loggerhead-instruments/OpenTag3/Manual/OpenTag3Top.JPG

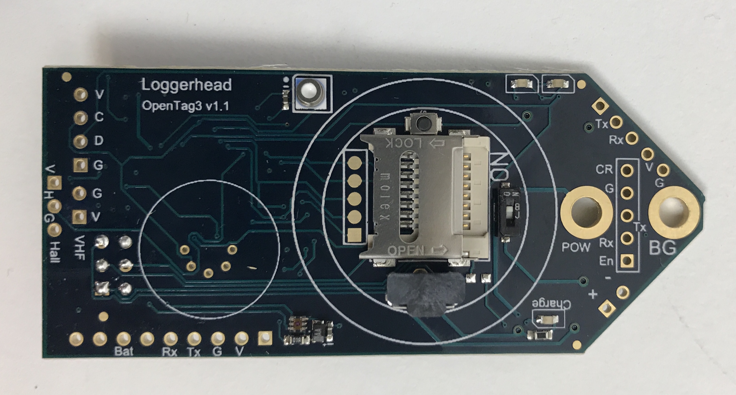
Manual/OpenTag3Top.JPG
