loggerhead-instruments/OpenTag3/Manual/OpenTag3Bottom.JPG

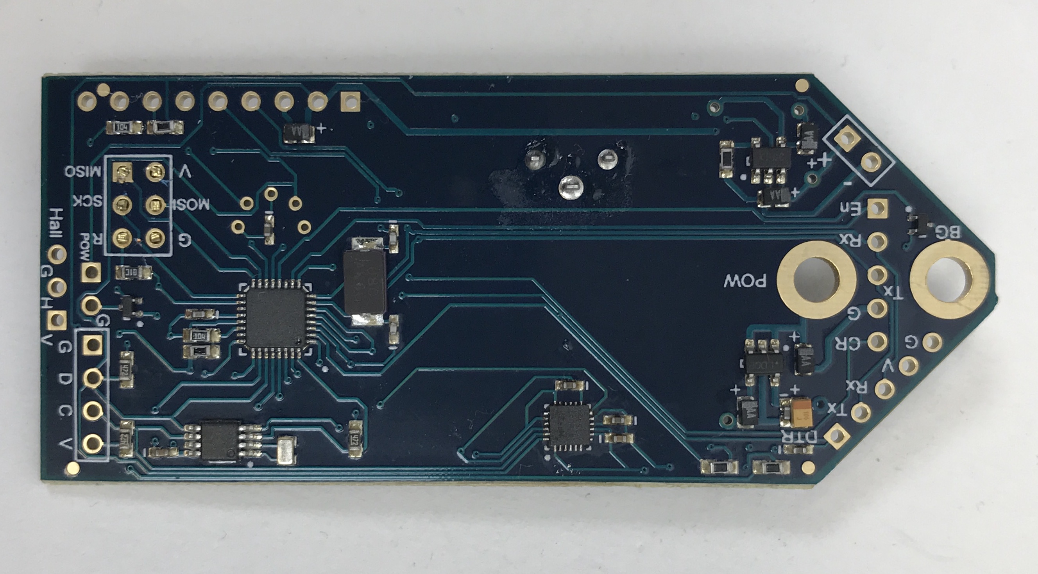
Manual/OpenTag3Bottom.JPG
