loggerhead-instruments/OpenTag3/README.md

# OpenTag3
Open source motion datalogger
