loggerhead-instruments/OpenTag3/Altium/OpenTag3.step

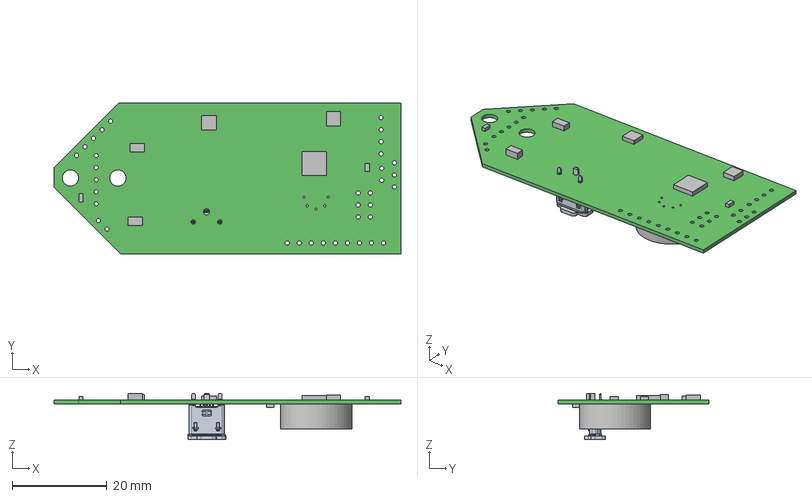
[picture p3: CAD file, 2017-10-24]
Altium/OpenTag3.step
73.2 x 31.8 x 9.80 mm
Board
Extruded x 8
