loggerhead-instruments/OpenTag3/(list of files, cad)

Other CAD files:
Altium/OpenTag3.DWG
