loggerhead-instruments/OpenTag3/Manual/OpenTag3.pptx

Pressure
Temperature

Stop

Status LEDs

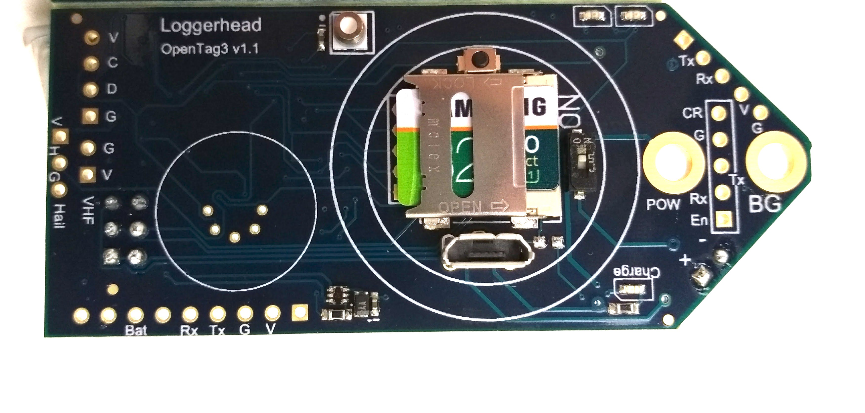
[picture p4: figure]

On/Off

Z (down)

X

Y

Burn Ground

+ Battery

Red when charging

Light
Sensor

microSD

microUSB charger
