loggerhead-instruments/OpenTag3/Manual/IMU_orientation.png

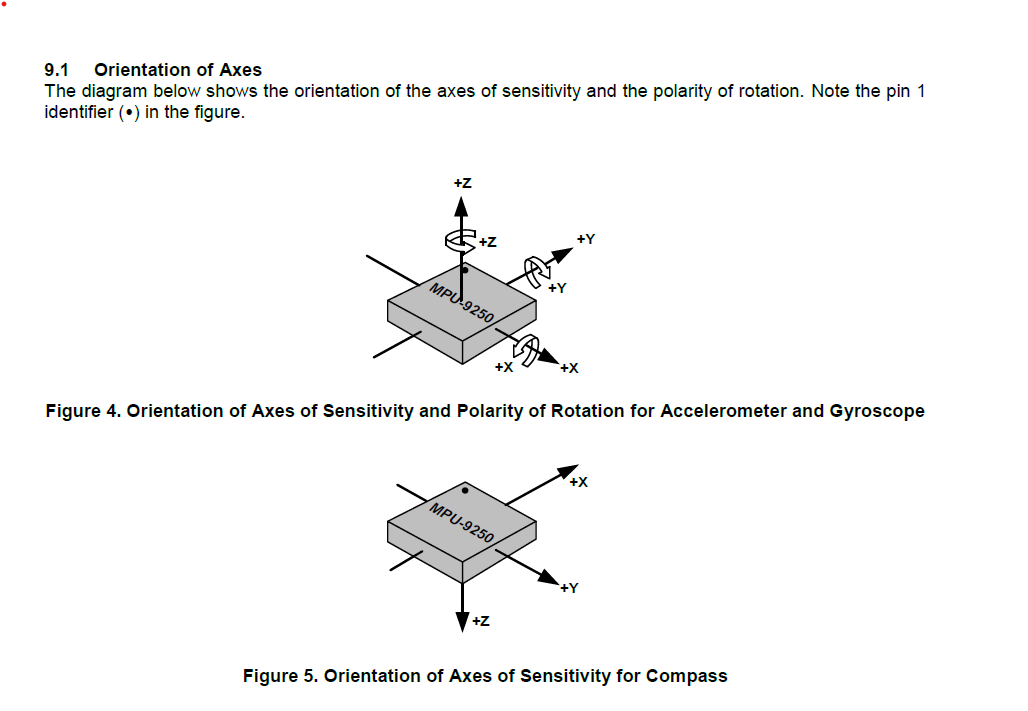
Manual/IMU_orientation.png
