loggerhead-instruments/OpenTag3/Manual/OpenTag3.png

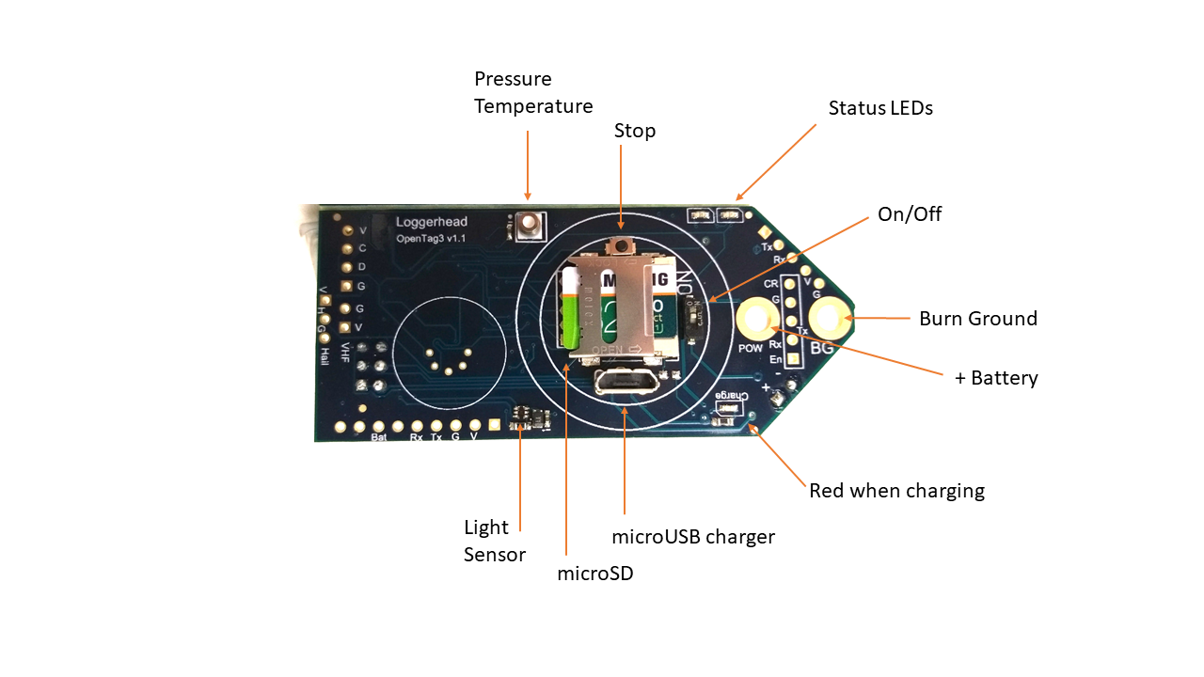
Manual/OpenTag3.png
