loggerhead-instruments/OpenTag3/MATLAB/OpenTag_NED_example_Data/NED_test.csv

accelX | accelY | accelZ | magX | magY | magZ | gyroX | gyroY | gyroZ
26 | 15 | -2141 | -117 | 355 | -39 | 38 | 18 | 2
49 | 3 | -2082 | -121 | 353 | -35 | 41 | -43 | 36
51 | -28 | -2085 | -119 | 365 | -47 | 5 | -38 | 17
42 | -13 | -2099 | -110 | 352 | -42 | -14 | -80 | -27
45 | 5 | -2102 | -120 | 358 | -44 | -20 | -39 | -20
59 | 28 | -2088 | -116 | 358 | -42 | -27 | 39 | 59
58 | 9 | -2085 | -113 | 359 | -39 | -37 | 40 | 108
38 | 23 | -2109 | -123 | 351 | -47 | -3 | 1 | 40
44 | 16 | -2105 | -114 | 354 | -42 | 49 | 25 | -62
57 | 22 | -2091 | -122 | 350 | -46 | 60 | 9 | -50
63 | 38 | -2092 | -118 | 350 | -48 | 49 | -9 | 22
54 | 17 | -2075 | -122 | 360 | -46 | 34 | -79 | 84
55 | -11 | -2085 | -111 | 357 | -45 | 4 | -10 | 89
35 | 22 | -2128 | -116 | 350 | -44 | -54 | 50 | 162
53 | 6 | -2107 | -115 | 353 | -39 | -16 | -65 | 134
58 | 3 | -2074 | -120 | 354 | -46 | -12 | -117 | 64
47 | 34 | -2099 | -112 | 352 | -46 | -46 | -74 | 73
29 | 41 | -2122 | -116 | 362 | -44 | -17 | 18 | 90
28 | 9 | -2111 | -114 | 360 | -48 | 3 | 44 | 130
45 | 23 | -2103 | -115 | 359 | -45 | -29 | -11 | 173
69 | 31 | -2062 | -123 | 355 | -39 | 25 | -4 | 77
32 | -30 | -2098 | -120 | 354 | -50 | 23 | -14 | 94
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
