loggerhead-instruments/OpenTag3/Manual/accelerometer_tag_assy-110619-1.pdf

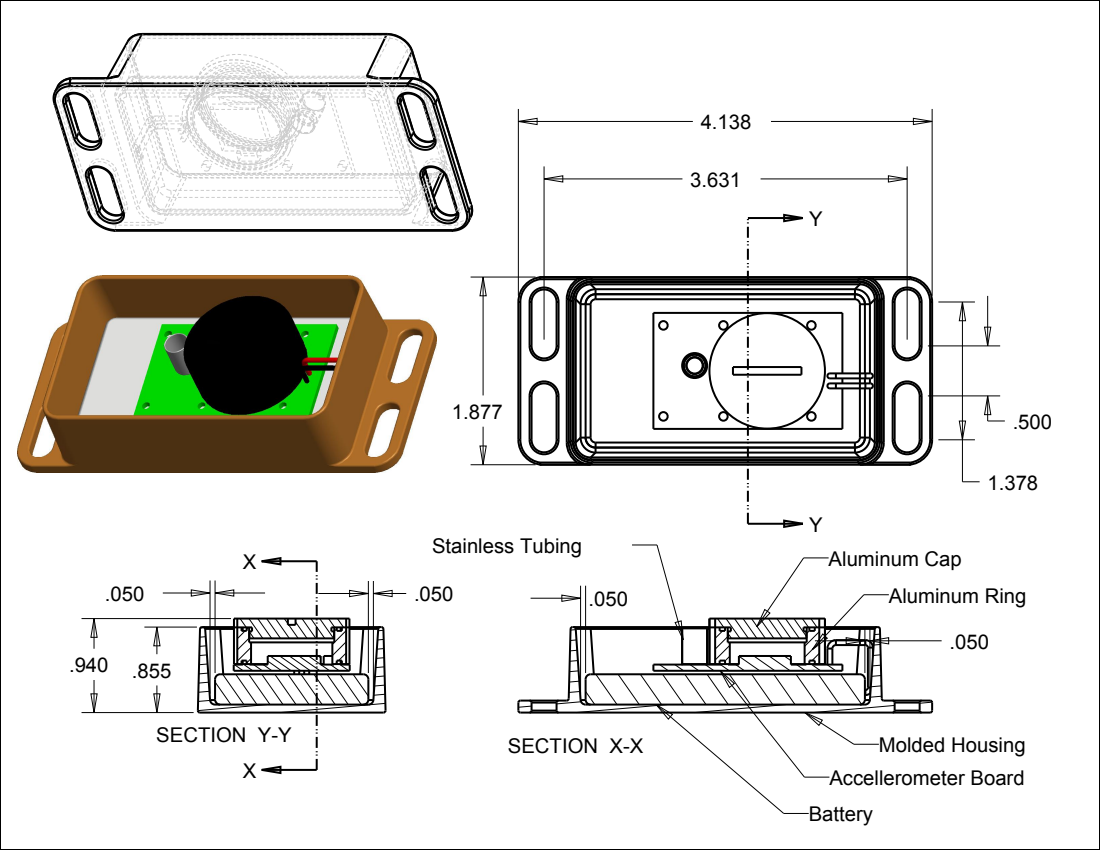
[picture p15: page 1]
SECTION Y-Y; Molded Housing; Aluminum Cap Aluminum Ring; Accellerometer Board Battery; SECTION X-X; Stainless Tubing
