loggerhead-instruments/OpenTag3/(list of files, drawings)

Other design files:
Altium/HallSensor/HallSensor.PcbDoc
Altium/HallSensor/HallSensor.PrjPCB
Altium/HallSensor/HallSensor.SchDoc
Altium/OpenTag3.PcbDoc
Altium/OpenTag3.PrjPCB
Altium/OpenTag3.SchDoc
Altium/OpenTag3_Sensors.SchDoc
