loggerhead-instruments/OpenTag3/Arduino/OpenTag3/OpenTag3.ino

// Copyright Loggerhead Instruments, 2017-2019
// David Mann

// OpenTag3 is an underwater motion datalogger
// designed around the ATMEGA328p

// OpenTag3 supports the following sensors:
// Pressure/Temperature
// acclerometer/magnetometer
// RGB light

// 2019-08-23: If no pressure sensor detected, don't sample it.
// 2019-03-05: Sleep uC and power down IMU during sleep interval.
//             showFail() returns after 10 seconds of blinking
// Run power: ~12 mA
// Sleep power: ~0.8 mA

//#include <Wire.h>
#include <SPI.h>
#include <SdFat.h>
#include <MsTimer2.h> 
#include <avr/sleep.h>
#include <avr/power.h>
#include <avr/wdt.h>
#include <prescaler.h>

#define SDA_PORT PORTC
#define SDA_PIN 4
#define SCL_PORT PORTC
#define SCL_PIN 5

#define I2C_TIMEOUT 100
#define I2C_FASTMODE 1

#include <SoftWire.h>
#include <avr/io.h>
#include <avr/boot.h>

SoftWire Wire = SoftWire();

//
// DEV SETTINGS
//
char codeVer[12] = "2020-04-27";
int printDiags = 1;

int recDur = 3600; // 3600 seconds per hour
int recInt = 0;
int LED_EN = 1; //enable green LEDs flash 1x per pressure read. Can be disabled from script.

boolean HALL_EN = 0; 
boolean HALL_LED_EN = 0; //flash red LED for Hall sensor
boolean ADC0_EN = 0;

#define pressAddress 0x76
float MS58xx_constant = 8192.0; // for 30 bar sensor
// float MS58xx_constant = 327680.0; // for 2 bar sensor; will switch to this if 30 bar fails to give good depth

// pin assignments
#define chipSelect  10
#define LED_GRN A3  // PD4
#define LED_RED 4 // PC3
#define BURN 8     // PB0
#define VHFPOW 9   // PB1
#define BUTTON1 A2 // PC2
#define BAT_VOLTAGE A7// ADC7
#define HALL 3 // PD3 (INT1)
#define CAM_TRIG 5 
#define CAM_EN 6  // High enables 5V power boost board

// SD file system
SdFat sd;
File dataFile;
int fileCount; 

int ssCounter; // used to get different sample rates from one timer based on imu_srate
byte clockprescaler=0;  //clock prescaler

//
// SENSORS
//
byte imuTempBuffer[20];
int imuSrate = 100; // must be integer for timer
int sensorSrate = 1; // must divide into imuSrate
int slowRateMultiple = imuSrate / sensorSrate;
int speriod = 1000 / imuSrate;

//Pressure and temp calibration coefficients
uint16_t PSENS; //pressure sensitivity
uint16_t POFF;  //Pressure offset
uint16_t TCSENS; //Temp coefficient of pressure sensitivity
uint16_t TCOFF; //Temp coefficient of pressure offset
uint16_t TREF;  //Ref temperature
uint16_t TEMPSENS; //Temperature sensitivity coefficient
byte Tbuff[3];
byte Pbuff[3];
volatile float depth, temperature, pressure_mbar;
boolean togglePress = 0; // flag to toggle conversion of temperature and pressure

// RGB
int16_t islRed;
int16_t islBlue;
int16_t islGreen;
int16_t accelX, accelY, accelZ;
int16_t magX, magY, magZ;
int16_t gyroX, gyroY, gyroZ;

int accel_scale = 16;

// impeller spin counter
volatile int spin;
volatile float adc0Val;

// System Modes and Status
int mode = 0; //standby = 0; running = 1
volatile float voltage;

// Time
volatile byte second = 0;
volatile byte minute = 0;
volatile byte hour = 17;
volatile byte day = 1;
volatile byte month = 1;
volatile byte year = 17;

unsigned long t, startTime, endTime, burnTime, startUnixTime;
int burnFlag = 0;
long burnSeconds;

void setup() {
  Serial.begin(115200);
  pinMode(LED_GRN, OUTPUT);
  pinMode(LED_RED, OUTPUT);
  pinMode(BURN, OUTPUT);
  pinMode(VHFPOW, OUTPUT);
  pinMode(BUTTON1, INPUT_PULLUP);
  pinMode(HALL, INPUT);
  pinMode(CAM_TRIG, OUTPUT);
  pinMode(CAM_EN, OUTPUT);
  if(ADC0_EN) pinMode(A0, INPUT);
  pinMode(BAT_VOLTAGE, INPUT);
  
  digitalWrite(BURN,LOW);
  digitalWrite(LED_RED,LOW);
  digitalWrite(LED_GRN,HIGH);
  digitalWrite(VHFPOW, LOW);
  digitalWrite(BURN, LOW);
  digitalWrite(CAM_TRIG, HIGH);
  digitalWrite(CAM_EN, HIGH);
  pinMode(2, INPUT); //Arduino Interrupt2
  pinMode(3, INPUT); //Arduino Interrupt1

  Serial.println("OT3");
  Wire.begin();
  
  Serial.println("microSD");
  // see if the card is present and can be initialized:
  sd.begin(chipSelect, SPI_FULL_SPEED);
//  while (!sd.begin(chipSelect, SPI_FULL_SPEED)) {
//    Serial.println("fail");
//    digitalWrite(LED_GRN, LOW);
//    digitalWrite(LED_RED, HIGH);
//    delay(200);
//    digitalWrite(LED_RED, LOW);
//    delay(100);
//  }
  loadScript(); // do this early to set time
  
  // recalculate sample rates in case changed from script
  slowRateMultiple = imuSrate / sensorSrate;
  speriod = 1000 / imuSrate;
  
  initSensors();
  readRTC();
  Serial.print(year); Serial.print("-");
  Serial.print(month);Serial.print("-");
  Serial.print(day);Serial.print(" ");
  Serial.print(hour);Serial.print(":");
  Serial.print(minute);Serial.print(":");
  Serial.println(second);

  startUnixTime = t;

 logFileWrite();
  
  if(burnFlag==2){
    burnTime = t + burnSeconds;
    Serial.print("Burn set");
    Serial.println(burnTime);
  }

  if(startTime==0) startTime = t + 10; // give some time for camera to power on
  Serial.print("Time:"); Serial.println(t);
  Serial.print("Start Time:"); Serial.println(startTime);
  digitalWrite(LED_GRN, LOW);
  digitalWrite(LED_RED, LOW);

  setClockPrescaler(clockprescaler); // set clockprescaler from script file
  wdtInit();
  //setupWDT(11); // initialize and activate WDT with maximum period (~500 ms)
}

void loop() {
  while(mode==0){
    // resetWdt();
    readRTC();
    checkBurn();
    checkVHF();
    Serial.print(t); Serial.print(" "); Serial.println(startTime);

    if(LED_EN){
      digitalWrite(LED_GRN, HIGH);
      digitalWrite(LED_RED, HIGH);
      delay(3);
    }
    digitalWrite(LED_GRN, LOW);
    digitalWrite(LED_RED, LOW);
    enterSleep();

    if(t >= startTime){
      endTime = startTime + recDur;
      startTime += recDur + recInt;  // this will be next start time for interval record
      mpuInit(1);
      fileInit();
      updateTemp();  // get first reading ready
      mode = 1;
      camStart();
      startInterruptTimer(speriod, clockprescaler);
      attachInterrupt(digitalPinToInterrupt(HALL), spinCount, RISING);
    }
  } // mode = 0


  while(mode==1){
    // resetWdt();
    
    // check if time to close
    if(t>=endTime){
      stopTimer();
      dataFile.close(); // close file
      if(t - startUnixTime > 3600) LED_EN = 0; // disable green LED flashing after 3600 s
      
      if(recInt==0){  // no interval between files
        endTime += recDur;  // update end time
        fileInit();
        startInterruptTimer(speriod, clockprescaler);
      }
      else{
        mode = 0;
        mpuInit(0); // MPU to sleep
      //  wdtInit(); // start wdt
      }
    }

    // Check if stop button pressed
    if(digitalRead(BUTTON1)==0){
      delay(10); // simple deBounce
      if(digitalRead(BUTTON1)==0){
        camStop();
        stopTimer();
        digitalWrite(LED_RED, HIGH);
        dataFile.close();
        delay(30000);
        // wait 30 s to stop
        startInterruptTimer(speriod, clockprescaler);
        fileInit();
        digitalWrite(LED_RED, LOW);
      }
    }

//    // Check if voltage is low
//    if(voltage < 3.3){
//      readVoltage(); // check again to be sure
//      if(voltage < 3.3){
//        camStop();
//        stopTimer();
//        dataFile.close();
//        // go into low power mode
//        mpuInit(0); // sleep IMU
//        islSleep(); // sleep light sensor
//        setClockPrescaler(3); // run at 1 MHz
//        delay(1000);
//        camPowOff();
//        digitalWrite(VHFPOW, HIGH); // turn on VHF
//        digitalWrite(BURN, HIGH);   // burn
//        while(1){
//          digitalWrite(LED_RED, HIGH);
//          delay(10);
//          digitalWrite(LED_RED, LOW);
//          delay(2000);
//        }
//      }
//    }
  } // mode = 1
}


boolean ledState;
void spinCount(){
  ledState = !ledState;
  if(HALL_LED_EN) digitalWrite(LED_RED, ledState);
  spin++;
}

void initSensors(){

  digitalWrite(VHFPOW, HIGH);
  digitalWrite(BURN, HIGH);

  
  
// Battery Voltage
      readVoltage();
      Serial.print(voltage);
      Serial.println(" V");

  if(voltage < 3.5){
    showFail(50); //battery voltage read fail
  }
  
  reset_alarm();

  readRTC();
  int oldSecond = second;

  // flash LED with current hour
  readRTC();
  Serial.print(year); Serial.print("-");
  Serial.print(month); Serial.print("-");
  Serial.print(day); Serial.print(" ");
  Serial.print(hour); Serial.print(":");
  Serial.print(minute); Serial.print(":");
  Serial.println(second);

  digitalWrite(LED_RED, HIGH);
  delay(1000);
  for(int i=0; i<hour; i++){
    delay(300);
    digitalWrite(LED_GRN, HIGH);
    delay(80);
    digitalWrite(LED_GRN, LOW);
  }
  delay(400);
  digitalWrite(LED_RED, LOW);
  readRTC();
  Serial.print(hour); Serial.print(":");
  Serial.print(minute); Serial.print(":");
  Serial.println(second);
  if(second==oldSecond){
    showFail(100); // clock not ticking
    Serial.println("Clock fail");
  }

  // Pressure/Temperature
  if (pressInit()==0){
    Serial.println("Pressure fail");
    showFail(200); // pressure sensor fail
  }
  Serial.println("P D T");
  for(int x=0; x<5; x++){
    updatePress();
    delay(100);
    readPress();
    updateTemp();
    delay(100);
    readTemp();
    calcPressTemp();
    Serial.print(pressure_mbar); Serial.print(" ");
    Serial.print(depth); Serial.print(" ");
    Serial.println(temperature);
  }

  if(depth<-1.0 | depth>1.0){
    // out of range, try settings for 2 bar sensor
    MS58xx_constant = 327680.0;
    calcPressTemp();
    Serial.print(pressure_mbar); Serial.print(" ");
    Serial.print(depth); Serial.print(" ");
    Serial.println(temperature);
  }

  if (islInit()==0) {
    Serial.println("RGB fail");
    showFail(200);
  }
  
  Serial.println("RGB");
  for (int x=0; x<8; x++){
    islRead();
    Serial.print(islRed); Serial.print("\t");
    Serial.print(islGreen); Serial.print("\t");
    Serial.println(islBlue);
    delay(100);
  }

  Serial.print("MPU");
  int eCode = mpuInit(1);
  if(eCode!=0) {
    Serial.print("MPU fail ");
    Serial.println(eCode);
    showFail(300);
  }
  for(int i=0; i<10; i++){
      readImu();
      calcImu();
      printImu();
      delay(100);
  }

  // sensor out of spec warning
  if(depth<-1.0 | depth>1.0 | islRed==0 | accelX==-1 | magX==-1 | gyroX==-1) {
    for(int i=0; i<300; i++){ //flash fast for  seconds
      digitalWrite(LED_RED, HIGH);
      delay(20);
      digitalWrite(LED_RED, LOW);
      delay(30);
    }
  }
  
  digitalWrite(VHFPOW, LOW);
  digitalWrite(BURN, LOW);
}

void showFail(int blinkInterval){
  digitalWrite(LED_GRN, LOW);
  int count = 5000 / blinkInterval;
  if(count < 100) count = 100;
  for(int n=0; n<count; n++){
    digitalWrite(LED_RED, HIGH);
    delay(blinkInterval);
    digitalWrite(LED_RED, LOW);
    delay(blinkInterval);
  }
}

void calcImu(){
  accelX = (int16_t) ((int16_t)imuTempBuffer[0] << 8 | imuTempBuffer[1]);    
  accelY = (int16_t) ((int16_t)imuTempBuffer[2] << 8 | imuTempBuffer[3]);   
  accelZ = (int16_t) ((int16_t)imuTempBuffer[4] << 8 | imuTempBuffer[5]);    
  
 // gyroTemp = (int16_t) (((int16_t)imuTempBuffer[6]) << 8 | imuTempBuffer[7]);   
 
  gyroX = (int16_t)  (((int16_t)imuTempBuffer[8] << 8) | imuTempBuffer[9]);   
  gyroY = (int16_t)  (((int16_t)imuTempBuffer[10] << 8) | imuTempBuffer[11]); 
  gyroZ = (int16_t)  (((int16_t)imuTempBuffer[12] << 8) | imuTempBuffer[13]);   
  
  magX = (int16_t)  (((int16_t)imuTempBuffer[14] << 8) | imuTempBuffer[15]);   
  magY = (int16_t)  (((int16_t)imuTempBuffer[16] << 8) | imuTempBuffer[17]);   
  magZ = (int16_t)  (((int16_t)imuTempBuffer[18] << 8) | imuTempBuffer[19]);  
}

void printImu(){
  Serial.print("a/m/g:\t");
  Serial.print(accelX); Serial.print("\t");
  Serial.print(accelY); Serial.print("\t");
  Serial.print(accelZ); Serial.print("\t");
  Serial.print(magX); Serial.print("\t");
  Serial.print(magY); Serial.print("\t");
  Serial.print(magZ); Serial.print("\t");
  Serial.print(gyroX); Serial.print("\t");
  Serial.print(gyroY); Serial.print("\t");
  Serial.println(gyroZ);
}

void fileWriteImu(){
  dataFile.print(accelX); dataFile.print(",");
  dataFile.print(accelY); dataFile.print(",");
  dataFile.print(accelZ); dataFile.print(",");
  dataFile.print(magX); dataFile.print(",");
  dataFile.print(magY); dataFile.print(",");
  dataFile.print(magZ); dataFile.print(",");
  dataFile.print(gyroX); dataFile.print(",");
  dataFile.print(gyroY); dataFile.print(",");
  dataFile.print(gyroZ);
}

void fileWriteSlowSensors(){
  dataFile.print(','); dataFile.print(year);  
  dataFile.print('-');
  if(month < 10) dataFile.print('0');
  dataFile.print(month);
  dataFile.print('-');
  if(day < 10) dataFile.print('0');
  dataFile.print(day);
  dataFile.print('T');
  if(hour) dataFile.print('0');
  dataFile.print(hour);
  dataFile.print(':');
  if(minute < 10) dataFile.print('0');
  dataFile.print(minute);
  dataFile.print(':');
  if(second < 10) dataFile.print('0');
  dataFile.print(second);
  dataFile.print("Z,");
  dataFile.print(islRed);
  dataFile.print(','); dataFile.print(islGreen);
  dataFile.print(','); dataFile.print(islBlue);
  dataFile.print(','); dataFile.print(pressure_mbar);
  dataFile.print(','); dataFile.print(depth);
  dataFile.print(','); dataFile.print(temperature);
  dataFile.print(','); dataFile.print(voltage);
  if(HALL_EN){
      dataFile.print(','); dataFile.print(spin);
  }
  if(ADC0_EN == 1) {
    dataFile.print(',');
    dataFile.print(adc0Val);
  }
}

void logFileWrite()
{
   readRTC();
   
   File logFile = sd.open("log.txt", O_WRITE | O_CREAT | O_APPEND);
   logFile.print("Code version:"); logFile.println(codeVer);
   logFile.print("Serial Number: ");
   for (uint8_t i = 14; i < 24; i += 1) {
       logFile.print(boot_signature_byte_get(i), HEX);
   }
   logFile.println();
   if(MS58xx_constant == 8192.0) {
    logFile.println("30 Bar");
   }
   else{
    logFile.println("2 Bar");
   }
   
   logFile.print(year);  logFile.print("-");
   logFile.print(month); logFile.print("-");
   logFile.print(day); logFile.print("T");
   logFile.print(hour); logFile.print(":");
   logFile.print(minute); logFile.print(":");
   logFile.println(second);

   logFile.close();
}


void flatFileOpen()
{
   readRTC();
   
   dataFile = sd.open("flat.csv", O_WRITE | O_CREAT);
   dataFile.println("accelX,accelY,accelZ,magX,magY,magZ");
   SdFile::dateTimeCallback(file_date_time);
}

void fileInit()
{
   char filename[60];
   sprintf(filename,"%02d%02d%02dT%02d%02d%02d.csv", year, month, day, hour, minute, second);  //filename is DDHHMM
   dataFile = sd.open(filename, O_WRITE | O_CREAT | O_APPEND);
   while (!dataFile){
    digitalWrite(LED_RED, HIGH);
    fileCount += 1;
    sprintf(filename,"F%06d.txt",fileCount); //if can't open just use count
    dataFile = sd.open(filename, O_WRITE | O_CREAT | O_EXCL);
    Serial.println(filename);
    delay(100);
   }
   digitalWrite(LED_RED, LOW);
   dataFile.print("accelX,accelY,accelZ,magX,magY,magZ,gyroX,gyroY,gyroZ,date,red,green,blue,mBar,depth,temperature,V");
   if(HALL_EN) dataFile.print(",spin");
   if(ADC0_EN == 1) dataFile.print(",O2");
   dataFile.println();
   SdFile::dateTimeCallback(file_date_time);
   Serial.println(filename);
}

/********************************************************************
***        Master Interrupt Routine to Read Sensors               ***
********************************************************************/
void sampleSensors(void){  
    ssCounter++;
    readImu();
    calcImu();
    fileWriteImu();

  // MS58xx start temperature conversion half-way through
  if((ssCounter>=(0.5 * slowRateMultiple))  & togglePress){ 
    readPress();   
    updateTemp();
    togglePress = 0;
  }
    
  if(ssCounter>=slowRateMultiple){
    // MS58xx pressure and temperature
    readTemp();
    updatePress();  
    togglePress = 1;
    
    if(LED_EN) digitalWrite(LED_GRN, HIGH);
    islRead(); // RGB in between to give temperature time to convert
    readRTC();
    checkVHF();
    checkBurn();
    calcPressTemp(); // MS58xx pressure and temperature
    readVoltage();
    if(ADC0_EN) adc0Val = readADC0(); // read ADC0 with averaging
    fileWriteSlowSensors();
    ssCounter = 0;
    spin = 0; //reset spin counter
    digitalWrite(LED_GRN, LOW);
  }
    
    dataFile.println();
}

//This function returns the date and time for SD card file access and modify time. One needs to call in setup() to register this callback function: SdFile::dateTimeCallback(file_date_time);
void file_date_time(uint16_t* date, uint16_t* time) 
{
  *date=FAT_DATE(year + 2000,month,day);
  *time=FAT_TIME(hour,minute,second);
}

int checkBurn(){
  if((t>=burnTime) & (burnFlag>0)){
    digitalWrite(BURN, HIGH);
    digitalWrite(VHFPOW, HIGH);
  }
}

void checkVHF(){
  if(depth<1.0) {
      digitalWrite(VHFPOW, HIGH);
    }
    else{
      if((depth>1.5)) {
        digitalWrite(VHFPOW, LOW);
      }
    }
}

void readVoltage(){
  voltage = analogRead(BAT_VOLTAGE) * 0.0042;
}

float readADC0(){
  uint16_t sumADC0 = 0;
  for(int i=0; i<10; i++){
    sumADC0 += analogRead(A0);
  }
  return (float) sumADC0 / 10.0;
}

void startInterruptTimer(int speriod, byte clockprescaler){
    MsTimer2::set(speriod>>clockprescaler, sampleSensors); // bitshift by clockprescaler...will round if not even
    MsTimer2::start();
}

void stopTimer(){
    MsTimer2::stop();
}

void camStart(){
    digitalWrite(CAM_TRIG, LOW);
    delay(500);
    digitalWrite(CAM_TRIG, HIGH);
}

void camStop(){
    digitalWrite(CAM_TRIG, LOW);
    delay(500);
    digitalWrite(CAM_TRIG, HIGH);
}

void camPowOff(){
  digitalWrite(CAM_EN, LOW);
}

void camPowOn(){
  digitalWrite(CAM_EN, HIGH);
}


ISR(WDT_vect)
{
    // do nothing
}


void enterSleep(void)
{
  set_sleep_mode(SLEEP_MODE_PWR_DOWN);   /* EDIT: could also use SLEEP_MODE_PWR_DOWN for lowest power consumption. */
  sleep_enable();
  
  /* Now enter sleep mode. */
  sleep_mode();
  
  /* The program will continue from here after the WDT timeout*/
  sleep_disable(); /* First thing to do is disable sleep. */
  
  /* Re-enable the peripherals. */
  power_all_enable();
}

void wdtInit(){
    /*** Setup the WDT ***/
  
  /* Clear the reset flag. */
  MCUSR &= ~(1<<WDRF);
  
  /* In order to change WDE or the prescaler, we need to
   * set WDCE (This will allow updates for 4 clock cycles).
   */
  WDTCSR |= (1<<WDCE) | (1<<WDE);

  /* set new watchdog timeout prescaler value */
  //WDTCSR = 1<<WDP0 | 1<<WDP3; /* 8.0 seconds */
  WDTCSR = (0<<WDP3 )|(1<<WDP2 )|(1<<WDP1)|(0<<WDP0);  // 1 s
  
  /* Enable the WD interrupt (note no reset). */
  WDTCSR |= _BV(WDIE);
}
