loggerhead-instruments/OpenTag3/Arduino/OpenTag3/cmd.ino

#define CMD(a,b) ( a + (b << 8))
#define TRUE 1
#define FALSE 0

int ProcCmd(char *pCmd)
{
  short *pCV;
  short n;
  long lv1;
  char s[22];
  unsigned int tday;
  unsigned int tmonth;
  unsigned int tyear;
  unsigned int thour;
  unsigned int tmin;
  unsigned int tsec;

  pCV = (short*)pCmd;

  n = strlen(pCmd);
  if(n<2) return TRUE;

  switch(*pCV)
  {                     
    
  // Accelerometer full scale
    case ('A' + ('G'<<8)):
    {
      sscanf(&pCmd[3],"%d",&lv1);
      accel_scale = lv1;
      break;
    }

    // Set Real Time Clock
    case ('T' + ('M'<<8)):
    {
         //set time
         Serial.print("Time ");
         sscanf(&pCmd[3],"%d-%d-%d %d:%d:%d",&tyear,&tmonth,&tday,&thour,&tmin,&tsec);
//         Serial.print(tyear); Serial.print(" ");
//         Serial.print(tmonth);Serial.print(" ");
//         Serial.print(tday);Serial.print(" ");
//         Serial.print(thour);Serial.print(" ");
//         Serial.print(tmin);Serial.print(" ");
//         Serial.print(tsec);
         setTime2(thour,tmin,tsec,tday,tmonth,tyear); 
         Serial.println(" set");
         break;
     }

    case ('B' + ('W'<<8)):
    {
         //set time
         sscanf(&pCmd[3],"%d-%d-%d %d:%d:%d",&tyear,&tmonth,&tday,&thour,&tmin,&tsec);
         burnTime = RTCToUNIXTime(tyear, tmonth, tday, thour, tmin, tsec);
         burnFlag = 1;
         break;
      }

     // Burn Minutes (burn set number of minutes after start)
      case ('B' + ('M'<<8)):
      {
           sscanf(&pCmd[3],"%d",&lv1);
           burnSeconds = lv1 * 60;
           burnFlag = 2;
           break;
      }


      case ('C' + ('P'<<8)):
      {
         sscanf(&pCmd[3],"%d",&lv1);
         clockprescaler=lv1;
         break; 
      }
                
      case ('S' + ('T'<<8)):
      {
        //start time
         sscanf(&pCmd[3],"%d-%d-%d %d:%d:%d",&tyear,&tmonth,&tday,&thour,&tmin,&tsec);
         startTime = RTCToUNIXTime(tyear, tmonth, tday, thour, tmin, tsec);
         break;
      } 
      

      
    case ('R' + ('D'<<8)):
    {
      sscanf(&pCmd[3],"%d",&lv1);
      recDur = lv1;
//      Serial.print("Rec dur:");
//      Serial.println(recDur);
      break;
    }
    
    case ('R' + ('I'<<8)):
    {
      sscanf(&pCmd[3],"%d",&lv1);
      recInt = lv1;
//      Serial.print("Rec int:");
//      Serial.println(recInt);
      break;
    } 

    case ('I' + ('S'<<8)):
    {
      sscanf(&pCmd[3],"%d",&lv1);
      imuSrate = lv1;
      break;
    }

    case ('P' + ('S'<<8)):
    {
      sscanf(&pCmd[3],"%d",&lv1);
      sensorSrate = lv1;
      break;
    }

    // disable LED
    case ('L' + ('D'<<8)):
    {
      LED_EN = 0;
      break;
    }

   // enable Hall
    case ('H' + ('E'<<8)):
    {
      HALL_EN = 1;
      break;
    }
    
   // enable Hall LED
    case ('H' + ('L'<<8)):
    {
      HALL_LED_EN = 1;
      break;
    }
  } 
  return TRUE;
}

boolean loadScript()
{
  char s[30];
  char c;
  short i;

  File file;
  unsigned long TM_byte;
  int comment_TM = 0;

  // Read card setup.txt file to set date and time, recording interval
 file=sd.open("setup.txt");
 if(file)
 {
   do{
        i = 0;
        s[i] = 0;
        do{
            c = file.read();
            if(c!='\r') s[i++] = c;
            if(c=='T') 
            {
              TM_byte = file.position() - 1;
              comment_TM = 1;
            }
            if(i>29) break;
          }while(c!='\n');
          s[--i] = 0;
          if(s[0] != '/' && i>1)
          {
            ProcCmd(s);
          }
      }while(file.available());
      file.close();  
      
      // comment out TM line if it exists
      if (comment_TM)
      {
        Serial.print("Comment TM ");
        Serial.println(TM_byte);
        file = sd.open("setup.txt", FILE_WRITE);
        file.seek(TM_byte);
        file.print("//");
        file.close();
      }
      
  }
  else
  {   
    Serial.println("no setup");

   // // display.println("no setup file");
    return 0;
  }
 return 1;  
}
