loggerhead-instruments/OpenTag3/(commit log)

2017-08-29 Initial schematic commit
    [OpenTag3.PrjPCB, OpenTag3.SchDoc, OpenTag3_Sensors.SchDoc]
2017-08-29 two schematics
    Split to two schematics
    Added Hall sensor
    Figured out interrupts--will need to use GreyGnome Change Interrupt library
    [OpenTag3.PrjPCB, OpenTag3.SchDoc, OpenTag3_Sensors.SchDoc]
2017-09-10 PCB update
    [OpenTag3.PcbDoc, OpenTag3.PrjPCB, OpenTag3.SchDoc, OpenTag3_Sensors.SchDoc]
2017-09-10 ignore PcbDocPreview
2017-09-10 support multiple sample rates
2017-09-19 fix FIFO sample rate bitmap
    [OpenTag3.ino]
2017-09-25 initial routing
    [OpenTag3.PcbDoc, OpenTag3.PrjPCB, OpenTag3.SchDoc, OpenTag3_Sensors.SchDoc]
2017-09-25 IMU routed
    [OpenTag3.PcbDoc]
2017-09-25 sensors routed
    [OpenTag3.PcbDoc, OpenTag3_Sensors.SchDoc]
2017-09-25 GPS routing
    [OpenTag3.PcbDoc, OpenTag3_Sensors.SchDoc]
2017-09-25 finish routing
    [OpenTag3.PcbDoc, OpenTag3.PrjPCB]
2017-10-19 read voltage
2017-10-19 pick and place
    [OpenTag3.PcbDoc, Pick Place for OpenTag3.csv]
2017-10-19 fix pressure/temperature update
    Initiate temperature conversion halfway between PT file writing to give time for conversion
    [MPU9250.ino, OpenTag3.ino]
2017-10-19 RTC and MPU9250 address conflict fixed
    [OpenTag3.PcbDoc, OpenTag3_Sensors.SchDoc]
2017-10-19 auto-comment TM in script
    So doesn't reset time more than once
    [cmd.ino]
2017-10-19 imu srate to script
2017-10-19 red led on for when counting green flashes to get hour
2017-10-19 Hall sensor on interrupt
2017-10-19 route Hall to INT; remove MS5803 pressure
    [OpenTag3.PcbDoc, OpenTag3.SchDoc, OpenTag3_Sensors.SchDoc]
2017-10-19 clean up routing
    [OpenTag3.PcbDoc]
2017-10-19 move digital signals farther from RTC
    [OpenTag3.PcbDoc]
2017-10-19 more cleanup
    [OpenTag3.PcbDoc]
2017-10-19 update version numbers
    [OpenTag3.PcbDoc, OpenTag3.SchDoc, OpenTag3_Sensors.SchDoc]
2017-10-19 move hall to board center
    [OpenTag3.PcbDoc]
2017-10-20 board shorter to fit in blue mold
    [OpenTag3.PcbDoc]
2017-10-24 silkscreen label all headers
    [OpenTag3.DWG, OpenTag3.PcbDoc, OpenTag3.step]
2017-11-15 update pressure to 2 bar sensor
2017-11-15 update text and move cap so solder mask doesn't merge
    [OpenTag3.PcbDoc, OpenTag3_Sensors.SchDoc]
2017-11-15 test voltage on startup
2017-11-15 flash red led with hall
2017-11-15 schematic PDF
2017-12-01 OpenTag BOM
    [OpenTag3.CSV]
2017-12-04 add define for controlling Hall sensor interrupt LED
2017-12-12 mag offset and gyro offset
    Code and test files
    [gyro_offset.csv, mag_offset.csv]
2017-12-12 fix NED orientation correction
    [NED_test.csv]
2018-02-06 Hall Sensor
    [HallSensor.PcbDoc, HallSensor.PrjPCB, HallSensor.SchDoc, OpenTag3BOM.xlsx]
2018-03-06 camera control
2018-03-06 fix#1 mode set incorrectly
    [OpenTag3.ino]
2018-03-06 stop interrupt when creating new file
    will drop a few samples, but that is better than corrupted file
    solution is to use FIFO on IMU
2018-03-12 update voltage
2018-04-05 check for low voltage
    Burn and turn on VHF if voltage low.
    Go into low power mode
    [OpenTag3.ino]
2018-04-05 move burn post
    [OpenTag3.PcbDoc, OpenTag3.SchDoc, OpenTag3_Sensors.SchDoc]
2018-04-05 rtc and burn uipdate outside of main fast loop
    Otherwise causes lockup
    Moved back into slow sensor sampling loop
    Alternate filename extension changed to .txt
    [OpenTag3.ino]
2018-04-06 10s start delay and informative LEDs
    Needed longer start delay to give camera time to boot up
2018-04-06 move burn out
    [OpenTag3.PcbDoc]
2018-04-19 HE Hall Enable red LED
    Default is hall sensor does not trigger red LED
    Add HE to script so that when Hall sensor triggered by impeller red LED flashes
2018-04-27 QC test
    If any sensor fails to initialize, flash red forever
    If any sensor out of range, flash red rapidly for 15s
    Burn on during startup so can read with voltmeter
    make text shorter to free up memory
    [MPU9250.ino, OpenTag3.ino, cmd.ino]
2018-04-27 fix depth calc
    don't use #define
    [MS58xx.ino, OpenTag3.ino]
2018-04-27 startup LED sequence
2018-04-27 log file shows pressure sensor range
2018-05-18 updated version number
    Change is to SDfat library to lower power draw
2018-10-29 sample slow sensors at 5 Hz
2019-03-05 sleep low power
    // 2019-03-05: Sleep uC and power down IMU during sleep interval.
    // showFail() returns after 10 seconds of blinking
    // Run power: ~12 mA
    // Sleep power: ~0.8 mA
2019-03-05 LEDs run for set amount of time at start
2019-03-05 LEDS stay on for 1 hour
2019-08-19 fix change sample rate from script
    [OpenTag3.ino]
2019-08-23 default to 100 Hz
2019-11-05 only log data for sensors present
2019-11-06 mold drawing
2020-05-19 testing sensors on startup
2020-11-23 OT3 update
    [OpenTag3.PcbDoc]
